jaw0/se7eduino/img/board.jpg

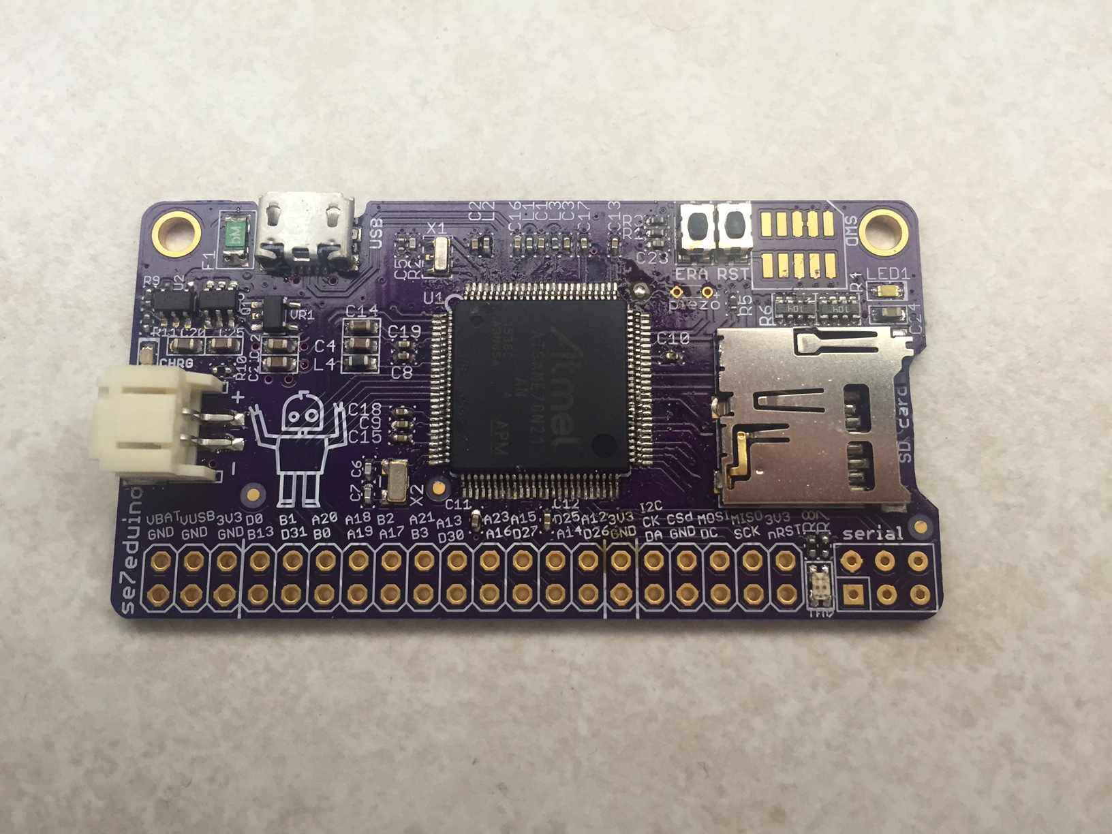
img/board.jpg
