jaw0/se7eduino/README.md

small atmel SAM S70 (300MHz cortex-M7) based dev board.
similar to the arduino due, except super-mega-turbocharged.

* 300 MHz ARM cortex-M7
* 2MB flash
* 384k RAM
* 480 Mbps high-speed USB
* micro sd card
* battery charger
* 64 x 34 mm
