jaw0/se7eduino/img/se7en.pdf

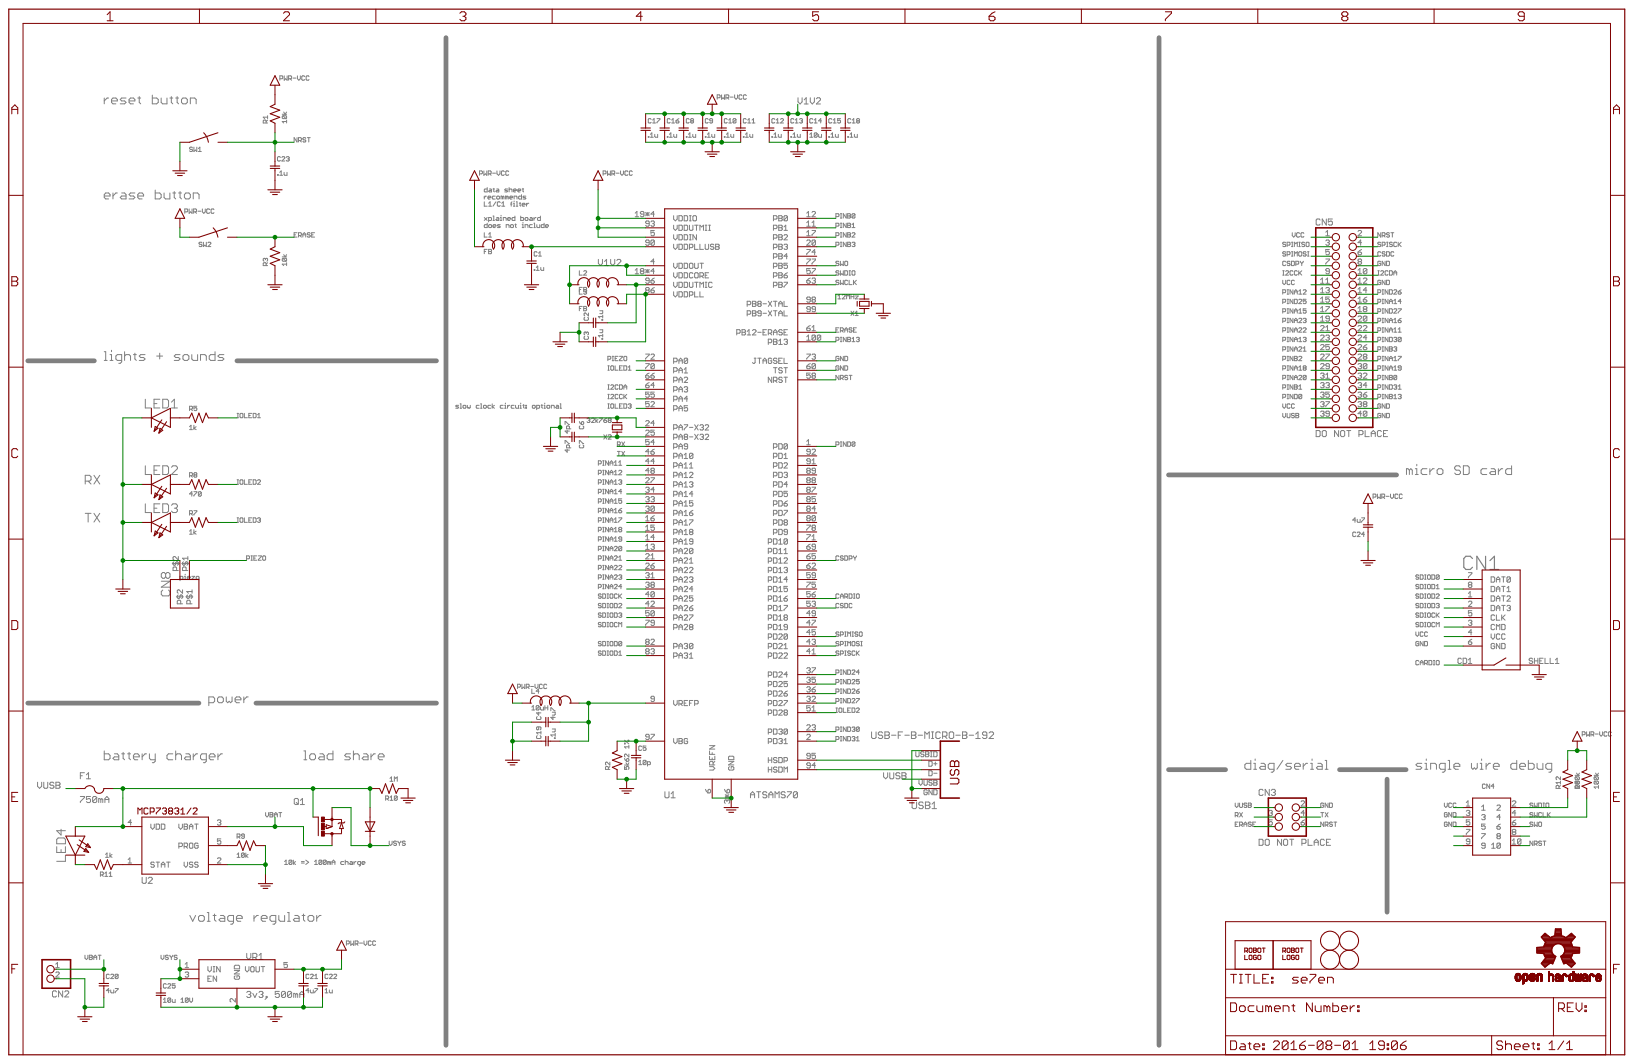
[picture p2: page 1]
