jaw0/se7eduino/cad/se7en.brd

## EAGLE design cad/se7en.brd (2016-08-02)

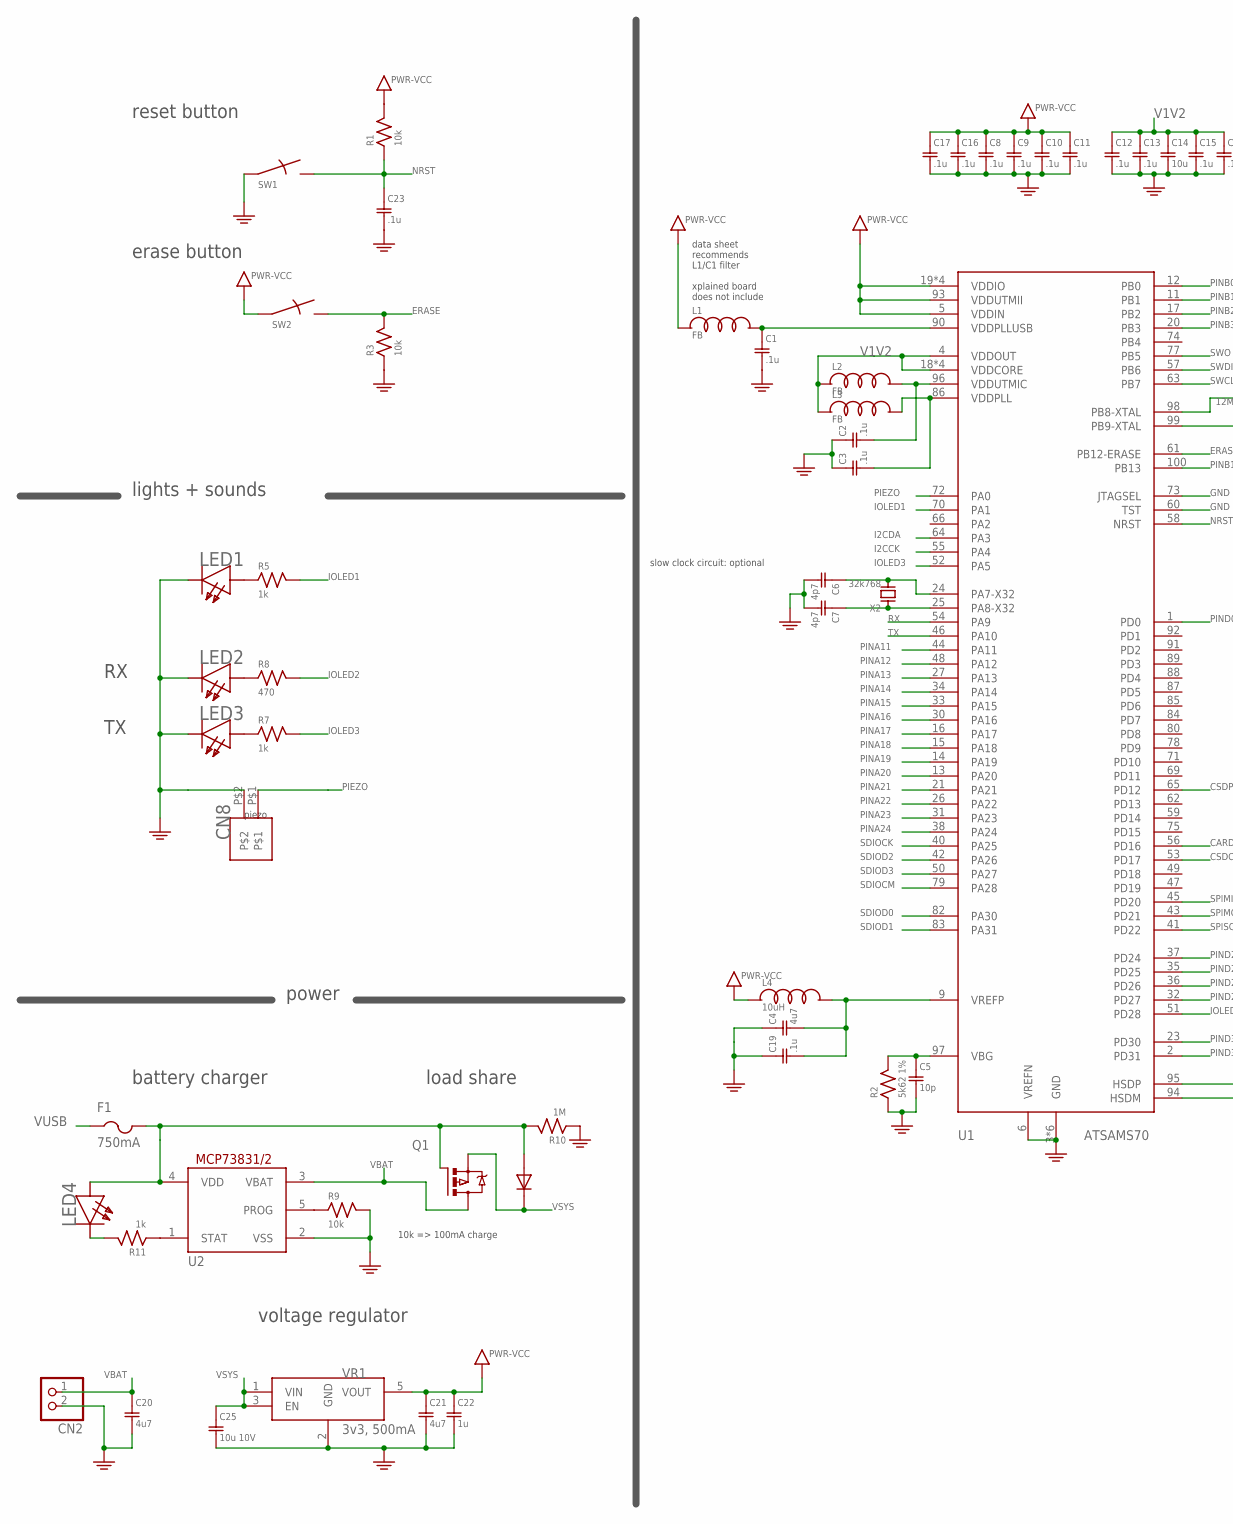
[picture p3: schematic se7en.sch, part in row 1, column 1]

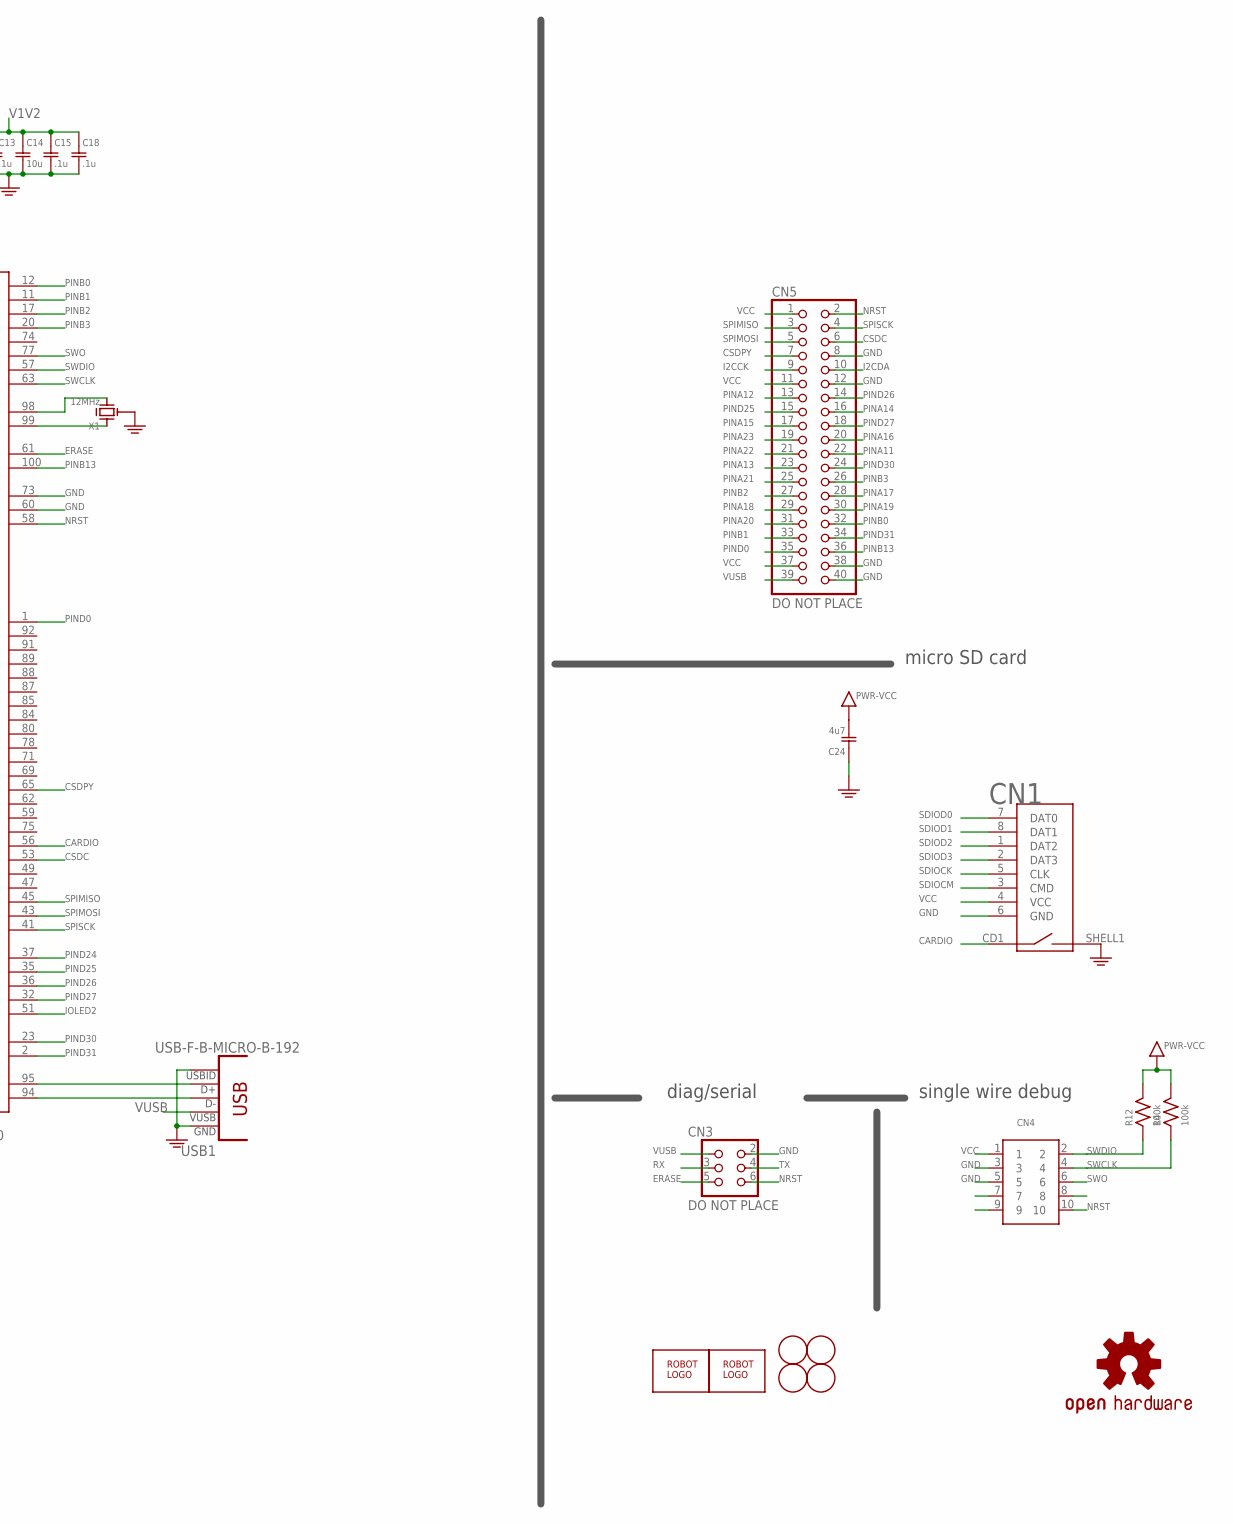
[picture p4: schematic se7en.sch, part in row 1, column 2]

Parts:
C1, C2, C3, C8, C9, C10, C11, C12, C13, C15, C16, C17, C18, C19, C23: .1u; SMD0402
C4, C20, C21, C24: 4u7; SMD0603
C5: 10p; SMD0402
C6, C7: 4p7; SMD0402
C14: 10u; SMD0603
C22: 1u; SMD0603
C25: 10u 10V; SMD0603
CN1: MICROSD-EJECT; MICROSD/EJECTOR
CN2: JST_2PIN-SMT-RA; JST-PH-2-SMT-RA
CN3: DO NOT PLACE; HEADER-3X2-POGO
CN4: DO NOT PLACE; M127-5X2-F
CN5: DO NOT PLACE; 2X20
CN8: DO NOT PLACE; HEADER-1X2-THM-TIGHT
F1: 750mA; SMD1206
L1, L2, L3: FB; SMD0402
L4: 10uH; SMD0603
LED1: white; SMD0603D
LED2: green; SMD0603D
LED3: orange; SMD0603D
LED4: RED; SMD0603D
LOGO$1: OSHW-LOGOM; OSHW-LOGO-M
Q1: FDC6392S; SOT-23-6
R1, R3, R9: 10k; SMD0402
R2: 5k62 1%; SMD0402
R4, R12: 100k; SMD0402
R5, R7, R11: 1k; SMD0402
R8: 470; SMD0402
R10: 1M; SMD0402
SW1, SW2: SWITCHKMR211; KMR211
U1: ATSAMS70; TQFP-100-14X14MM
U2: MCP73831; SOT-23-5
U$1, U$3: ROBOTMAN-LOGO2
U$2, U$4, U$5, U$6: FIDUCIAL; FIDUCIAL_1MM
USB1: USB-F-B-MICRO-B-192; USB-MICRO-B-192
VR1: 3v3, 500mA; SOT-23-5
X1: 12MHz; RESONATOR-CSTCE
X2: 32k768; XTAL-32X15

Connections:
CARDIO: CN1.CD1 (SW1), U1.56 (PD16)
CSDC: CN5.6, U1.53 (PD17)
CSDPY: CN5.7, U1.65 (PD12)
ERASE: CN3.5, R3.2, SW2.2, SW2.4, U1.61 (PB12-ERASE)
GND: C1.2, C2.1, C3.1, C4.1, C5.2, C6.2, C7.2, C8.2, C9.2, C10.2, C11.2, C12.2, C13.2, C14.2, C15.2, C16.2, C17.2, C18.2, C19.1, C20.2, C21.2, C22.2, C23.2, C24.1, C25.2, CN1.6 (GND), CN1.SHELL1 (SW2), CN2.2 (1), CN3.2, CN4.3, CN4.5, CN5.8, CN5.12, CN5.38, CN5.40, CN8.P$2, LED1.C, LED2.C, LED3.C, R2.1, R3.1, R9.2, R10.1, SW1.1, SW1.3, U1.3 (GND), U1.6 (VREFN), U1.7 (GND), U1.8 (GND), U1.10 (GND), U1.29 (GND), U1.60 (TST), U1.67 (GND), U1.73 (JTAGSEL), U2.2 (VSS), USB1.P4 (USBID), USB1.P5 (GND), VR1.2 (GND), X1.2 (G)
I2CCK: CN5.9, U1.55 (PA4)
I2CDA: CN5.10, U1.64 (PA3)
IOLED1: R5.2, U1.70 (PA1)
IOLED2: R8.2, U1.51 (PD28)
IOLED3: R7.2, U1.52 (PA5)
unnamed: C2.2, L2.2, U1.96 (VDDUTMIC)
unnamed: C1.1, L1.2, U1.90 (VDDPLLUSB)
unnamed: C3.2, L3.2, U1.86 (VDDPLL)
unnamed: LED2.A, R8.1
unnamed: LED3.A, R7.1
unnamed: U1.98 (PB8-XTAL), X1.3 (X2)
unnamed: C5.1, R2.2, U1.97 (VBG)
unnamed: U1.99 (PB9-XTAL), X1.1 (X1)
unnamed: C7.1, U1.25 (PA8-X32), X2.P$1
unnamed: R11.1, U2.1 (STAT)
unnamed: C6.1, U1.24 (PA7-X32), X2.P$2
unnamed: LED4.C, R11.2
unnamed: LED1.A, R5.1
unnamed: R9.1, U2.5 (PROG)
NRST: C23.1, CN3.6, CN4.10, CN5.2, R1.1, SW1.2, SW1.4, U1.58 (NRST)
PIEZO: CN8.P$1, U1.72 (PA0)
PINA11: CN5.22, U1.44 (PA11)
PINA12: CN5.13, U1.48 (PA12)
PINA13: CN5.23, U1.27 (PA13)
PINA14: CN5.16, U1.34 (PA14)
PINA15: CN5.17, U1.33 (PA15)
PINA16: CN5.20, U1.30 (PA16)
PINA17: CN5.28, U1.16 (PA17)
PINA18: CN5.29, U1.15 (PA18)
PINA19: CN5.30, U1.14 (PA19)
PINA20: CN5.31, U1.13 (PA20)
PINA21: CN5.25, U1.21 (PA21)
PINA22: CN5.21, U1.26 (PA22)
PINA23: CN5.19, U1.31 (PA23)
PINA24: U1.38 (PA24)
PINB0: CN5.32, U1.12 (PB0)
PINB1: CN5.33, U1.11 (PB1)
PINB2: CN5.27, U1.17 (PB2)
PINB3: CN5.26, U1.20 (PB3)
PINB13: CN5.36, U1.100 (PB13)
PIND0: CN5.35, U1.1 (PD0)
PIND24: U1.37 (PD24)
PIND25: CN5.15, U1.35 (PD25)
PIND26: CN5.14, U1.36 (PD26)
PIND27: CN5.18, U1.32 (PD27)
PIND30: CN5.24, U1.23 (PD30)
PIND31: CN5.34, U1.2 (PD31)
RX: CN3.3, U1.54 (PA9)
SDIOCK: CN1.5 (CLK), U1.40 (PA25)
SDIOCM: CN1.3 (CMD), U1.79 (PA28)
SDIOD0: CN1.7 (DAT0), U1.82 (PA30)
SDIOD1: CN1.8 (DAT1), U1.83 (PA31)
SDIOD2: CN1.1 (DAT2), U1.42 (PA26)
SDIOD3: CN1.2 (DAT3), U1.50 (PA27)
SPIMISO: CN5.3, U1.45 (PD20)
SPIMOSI: CN5.5, U1.43 (PD21)
SPISCK: CN5.4, U1.41 (PD22)
SWCLK: CN4.4, R4.1, U1.63 (PB7)
SWDIO: CN4.2, R12.1, U1.57 (PB6)
SWO: CN4.6, U1.77 (PB5)
TX: CN3.4, U1.46 (PA10)
USBDM: U1.94 (HSDM), USB1.P2 (D-)
USBDP: U1.95 (HSDP), USB1.P3 (D+)
V1V2: C12.1, C13.1, C14.1, C15.1, C18.1, L2.1, L3.1, U1.4 (VDDOUT), U1.18 (VDDCORE), U1.22 (VDDCORE), U1.39 (VDDCORE), U1.76 (VDDCORE)
VBAT: C20.1, CN2.1 (2), Q1.4 (D), U2.3 (VBAT)
VCC: C8.1, C9.1, C10.1, C11.1, C16.1, C17.1, C21.1, C22.1, C24.2, CN1.4 (VCC), CN4.1, CN5.1, CN5.11, CN5.37, L1.1, L4.1, R1.2, R4.2, R12.2, SW2.1, SW2.3, U1.5 (VDDIN), U1.19 (VDDIO), U1.28 (VDDIO), U1.68 (VDDIO), U1.81 (VDDIO), U1.93 (VDDUTMII), VR1.5 (VOUT)
VCCA: C4.2, C19.2, L4.2, U1.9 (VREFP)
VIN: F1.2, LED4.A, Q1.1 (A), Q1.3 (G), R10.2, U2.4 (VDD)
VSYS: C25.1, Q1.2 (S), Q1.6 (C), VR1.1 (VIN), VR1.3 (EN)
VUSB: CN3.1, CN5.39, F1.1, USB1.P1 (VUSB)

Notes on the sheet:
piezo
battery charger
load share
voltage regulator
diag/serial
single wire debug
micro SD card
reset button
erase button
lights + sounds
power
slow clock circuit: optional
data sheet recommends L1/C1 filter xplained board does not include
10k => 100mA charge

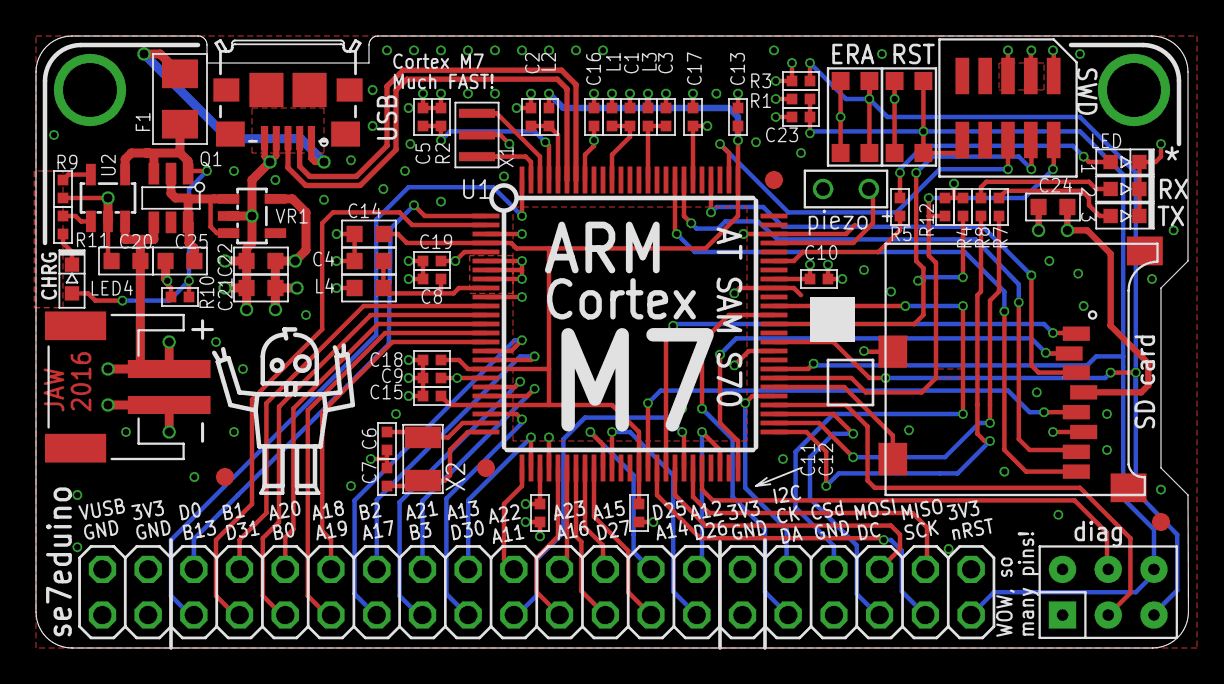
[picture p5: board se7en.brd from above]

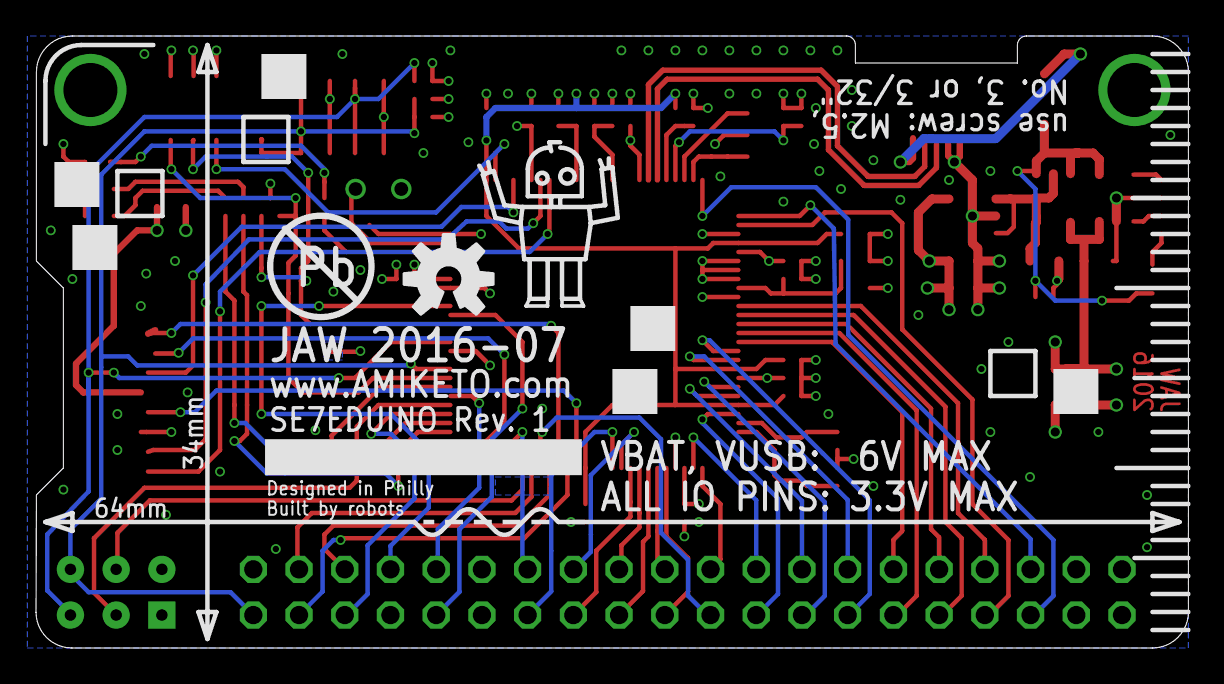
[picture p6: board se7en.brd from below]

Board: 4 copper layers, 64.0 x 34.0 mm, 67 parts (2 on the bottom side), 73 nets.
