jaw0/se7eduino/(commit log)

2016-05-28 atmel sam s70 board
    [se7en.brd, se7en.sch]
2016-05-29 replace A22 with A12
    [se7en.brd, se7en.sch]
2016-05-30 smaller/cheaper regulator
    [se7en.brd, se7en.sch]
2016-06-08 new board
    [7duino.brd, 7duino.sch]
2016-06-09 move files
    [7duino.brd, 7duino.sch]
2016-06-21 fix typo
    [se7en.brd, se7en.sch]
2016-06-21 tweak orientation
    [se7en.brd, se7en.sch]
2016-06-26 scootch back from edge, tweak silk
    [se7en.brd]
2016-06-29 remove pullups (use pio pullups)
    [se7en.brd, se7en.sch]
2016-07-01 move LEDs
    [se7en.brd, se7en.sch]
2016-07-03 piezo conn
    [se7en.brd, se7en.sch]
2016-07-06 usb improve Zd
    [se7en.brd, se7en.sch]
2016-07-07 drop vbat pins, add more io
    [se7en.brd, se7en.sch]
2016-08-02 brighten green
    [se7en.brd, se7en.sch]
